Mapy542/ch32m030/ch32v307drv/layout images/Screenshot_20260525_173055.png

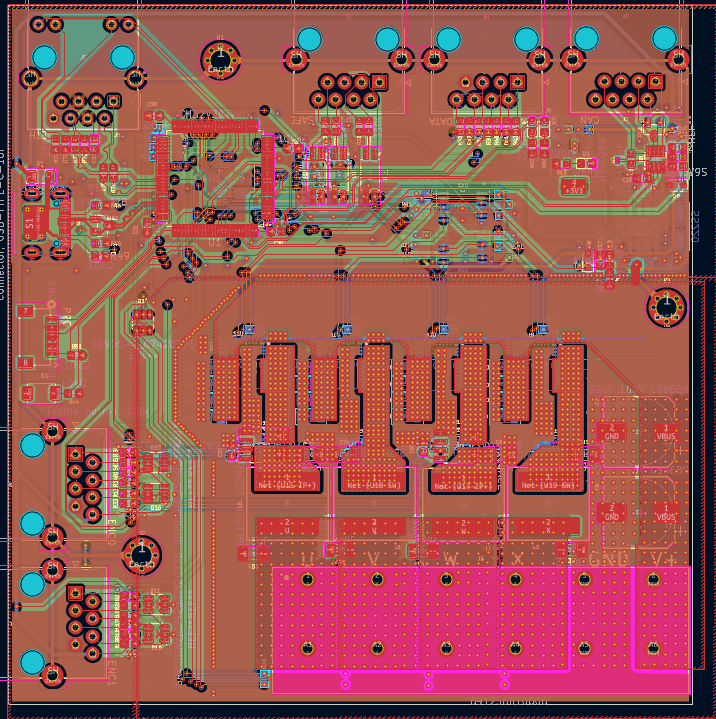
ch32v307drv/layout images/Screenshot_20260525_173055.png
