Mapy542/ch32m030/ch32v307drv/BSC019N06NSATMA1 (1)/BSC019N06NSATMA1.step

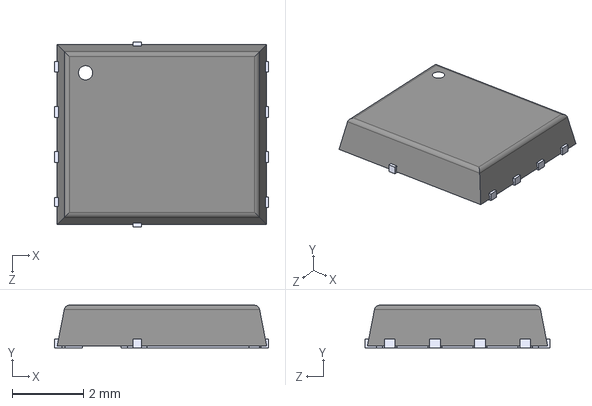
[picture p15: CAD file, 2026-04-23]
ch32v307drv/BSC019N06NSATMA1 (1)/BSC019N06NSATMA1.step
6.03 x 1.20 x 5.21 mm
