Mapy542/ch32m030/ch32v307drv/CH221K/CH221K.step

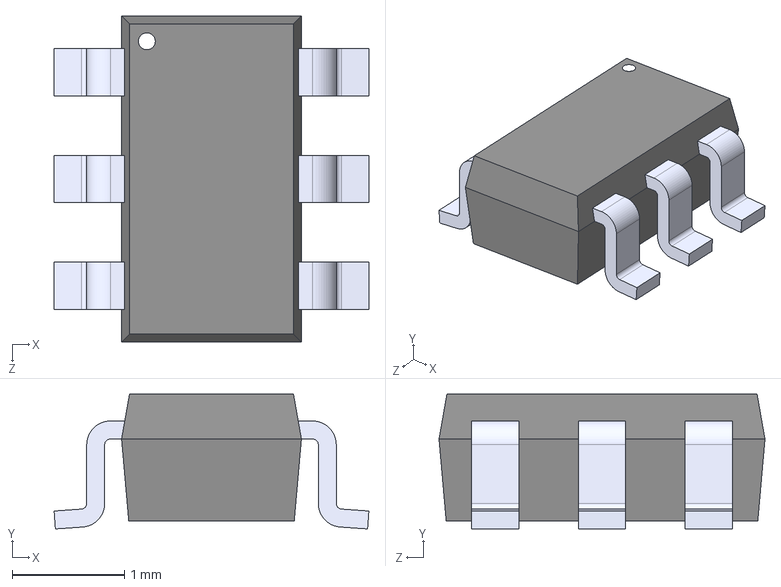
[picture p16: CAD file, 2026-04-23]
ch32v307drv/CH221K/CH221K.step
2.80 x 1.20 x 2.90 mm
