Mapy542/ch32m030/ch32v307drv/SM06B_SRSS_TB_LF__SN_/KiCADv6/SM06B-SRSS-TB.STEP

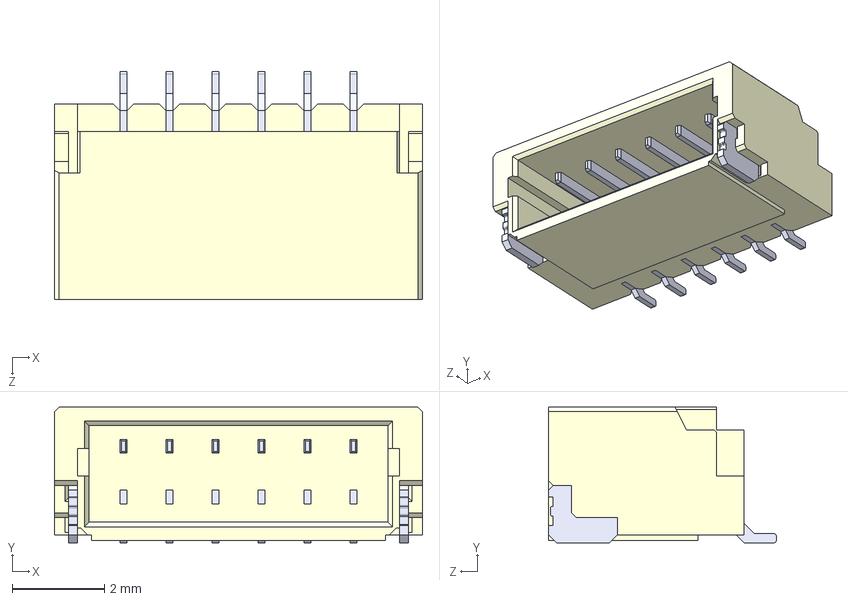
[picture p17: CAD file, 2026-04-23]
ch32v307drv/SM06B_SRSS_TB_LF__SN_/KiCADv6/SM06B-SRSS-TB.STEP
8.00 x 2.95 x 4.95 mm
