Mapy542/ch32m030/ch32v307drv/SS_641010S_A_NF (1)/SS-641010S-A-NF.STEP

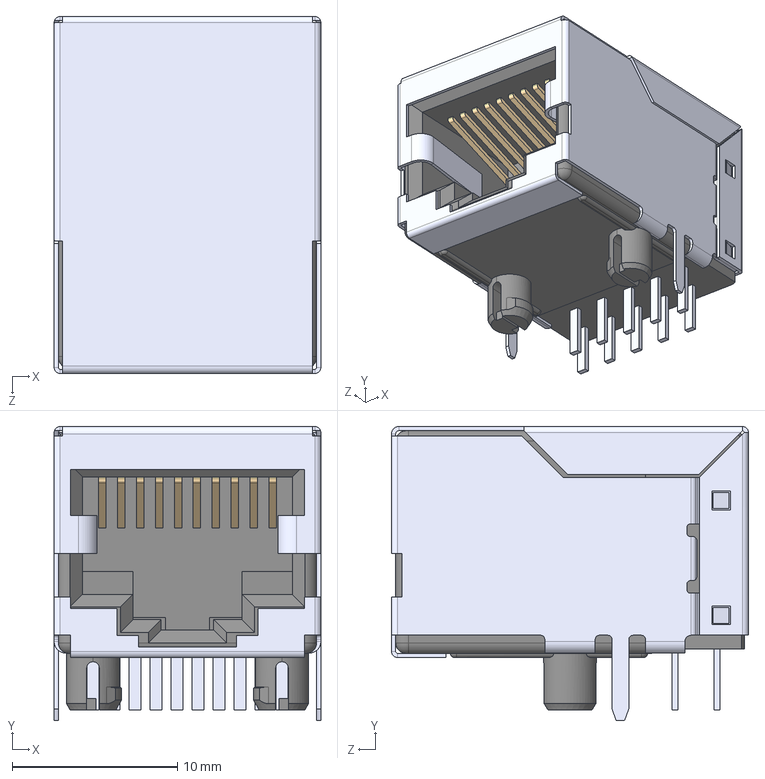
[picture p18: CAD file, 2026-06-03]
ch32v307drv/SS_641010S_A_NF (1)/SS-641010S-A-NF.STEP
16.1 x 17.8 x 21.6 mm
