Mapy542/ch32m030/ch32v307drv/SS_6466S_A_PG1/SS-6466S-A-PG1.stp

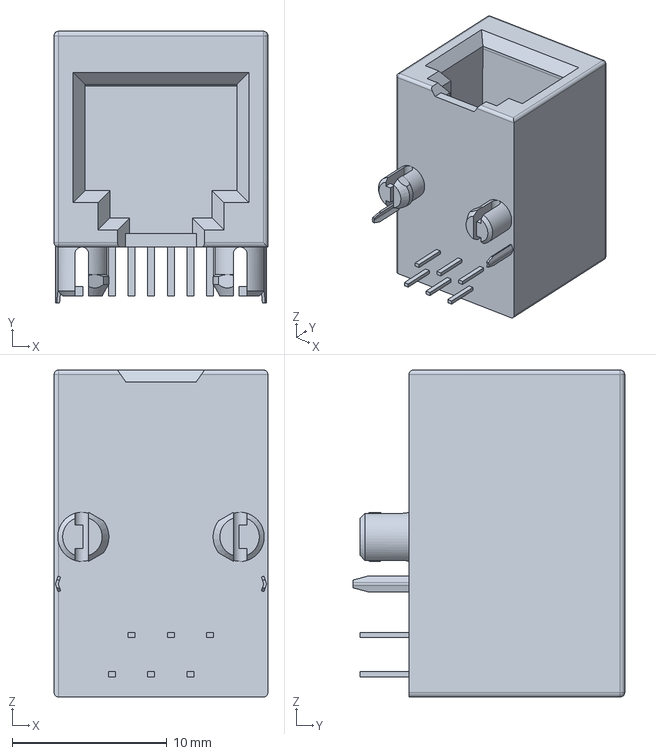
[picture p19: CAD file, 2026-06-03]
ch32v307drv/SS_6466S_A_PG1/SS-6466S-A-PG1.stp
13.8 x 17.6 x 21.2 mm
