Mapy542/ch32m030/ch32v307drv/TBL002A_350_10GY_2GY (1)/TBL002A-350-10GY-2GY.step

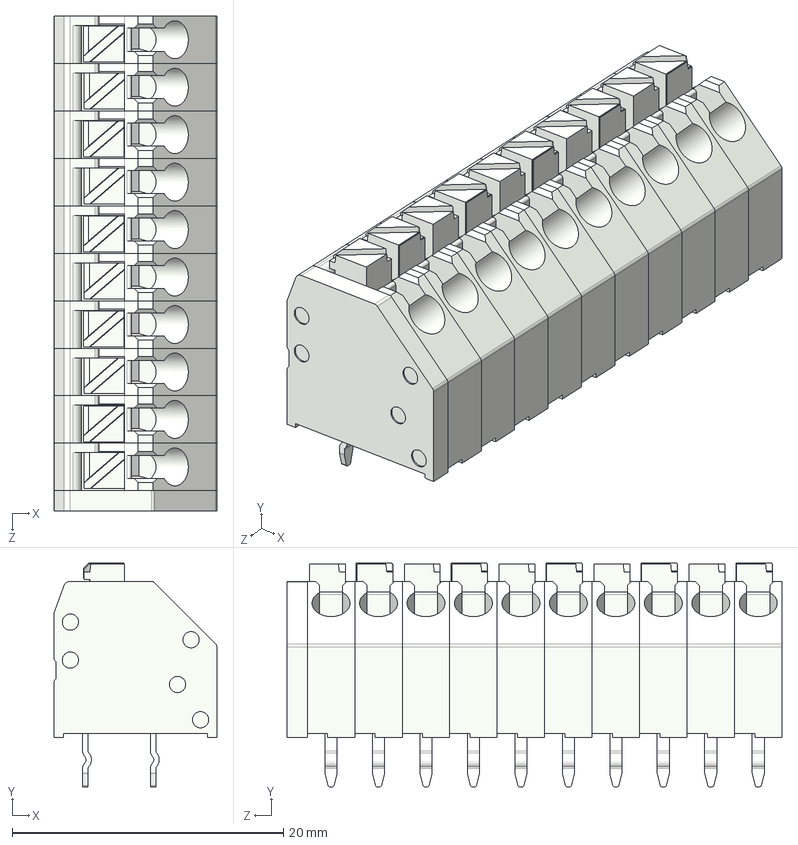
[picture p20: CAD file, 2026-04-23]
ch32v307drv/TBL002A_350_10GY_2GY (1)/TBL002A-350-10GY-2GY.step
12.0 x 16.5 x 36.5 mm
TBL002A-350 - END CAP_Gray
TBL002A-350 - BODY A_Gray x 5
TBL002A-350 - BODY B_Gray x 5
TBL002A-350 - PUSH BUTTON A_Gray x 5
TBL002A-350 - PUSH BUTTON B_Gray x 5
