Mapy542/ch32m030/ch32v307drv/691256610006 (1)/691256610006.stp

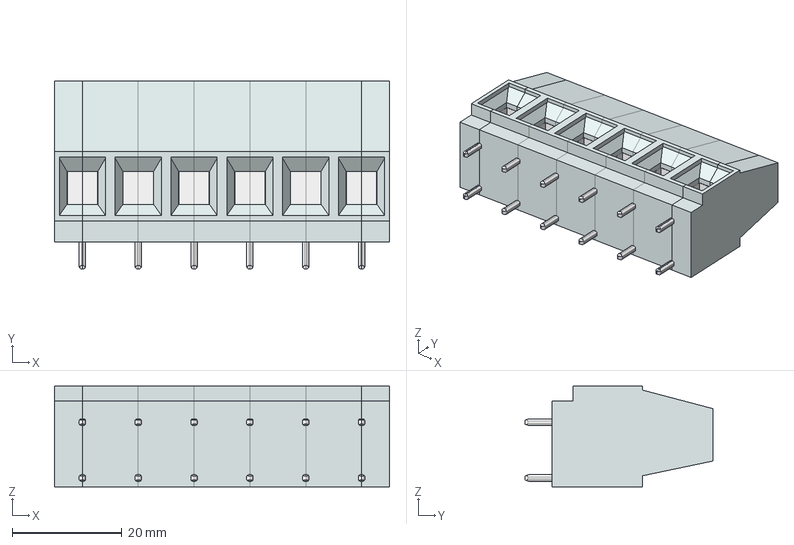
[picture p21: CAD file, 2026-04-23]
ch32v307drv/691256610006 (1)/691256610006.stp
61.0 x 34.3 x 18.3 mm
MRT26P10.16_SX
MRT26P10.16_CNT x 5
MRT26P10.16_DX
