Mapy542/ch32m030/ch32m030/ch32m030.kicad_pcb

## KiCad design ch32m030/ch32m030.kicad_pcb (2026-06-03)

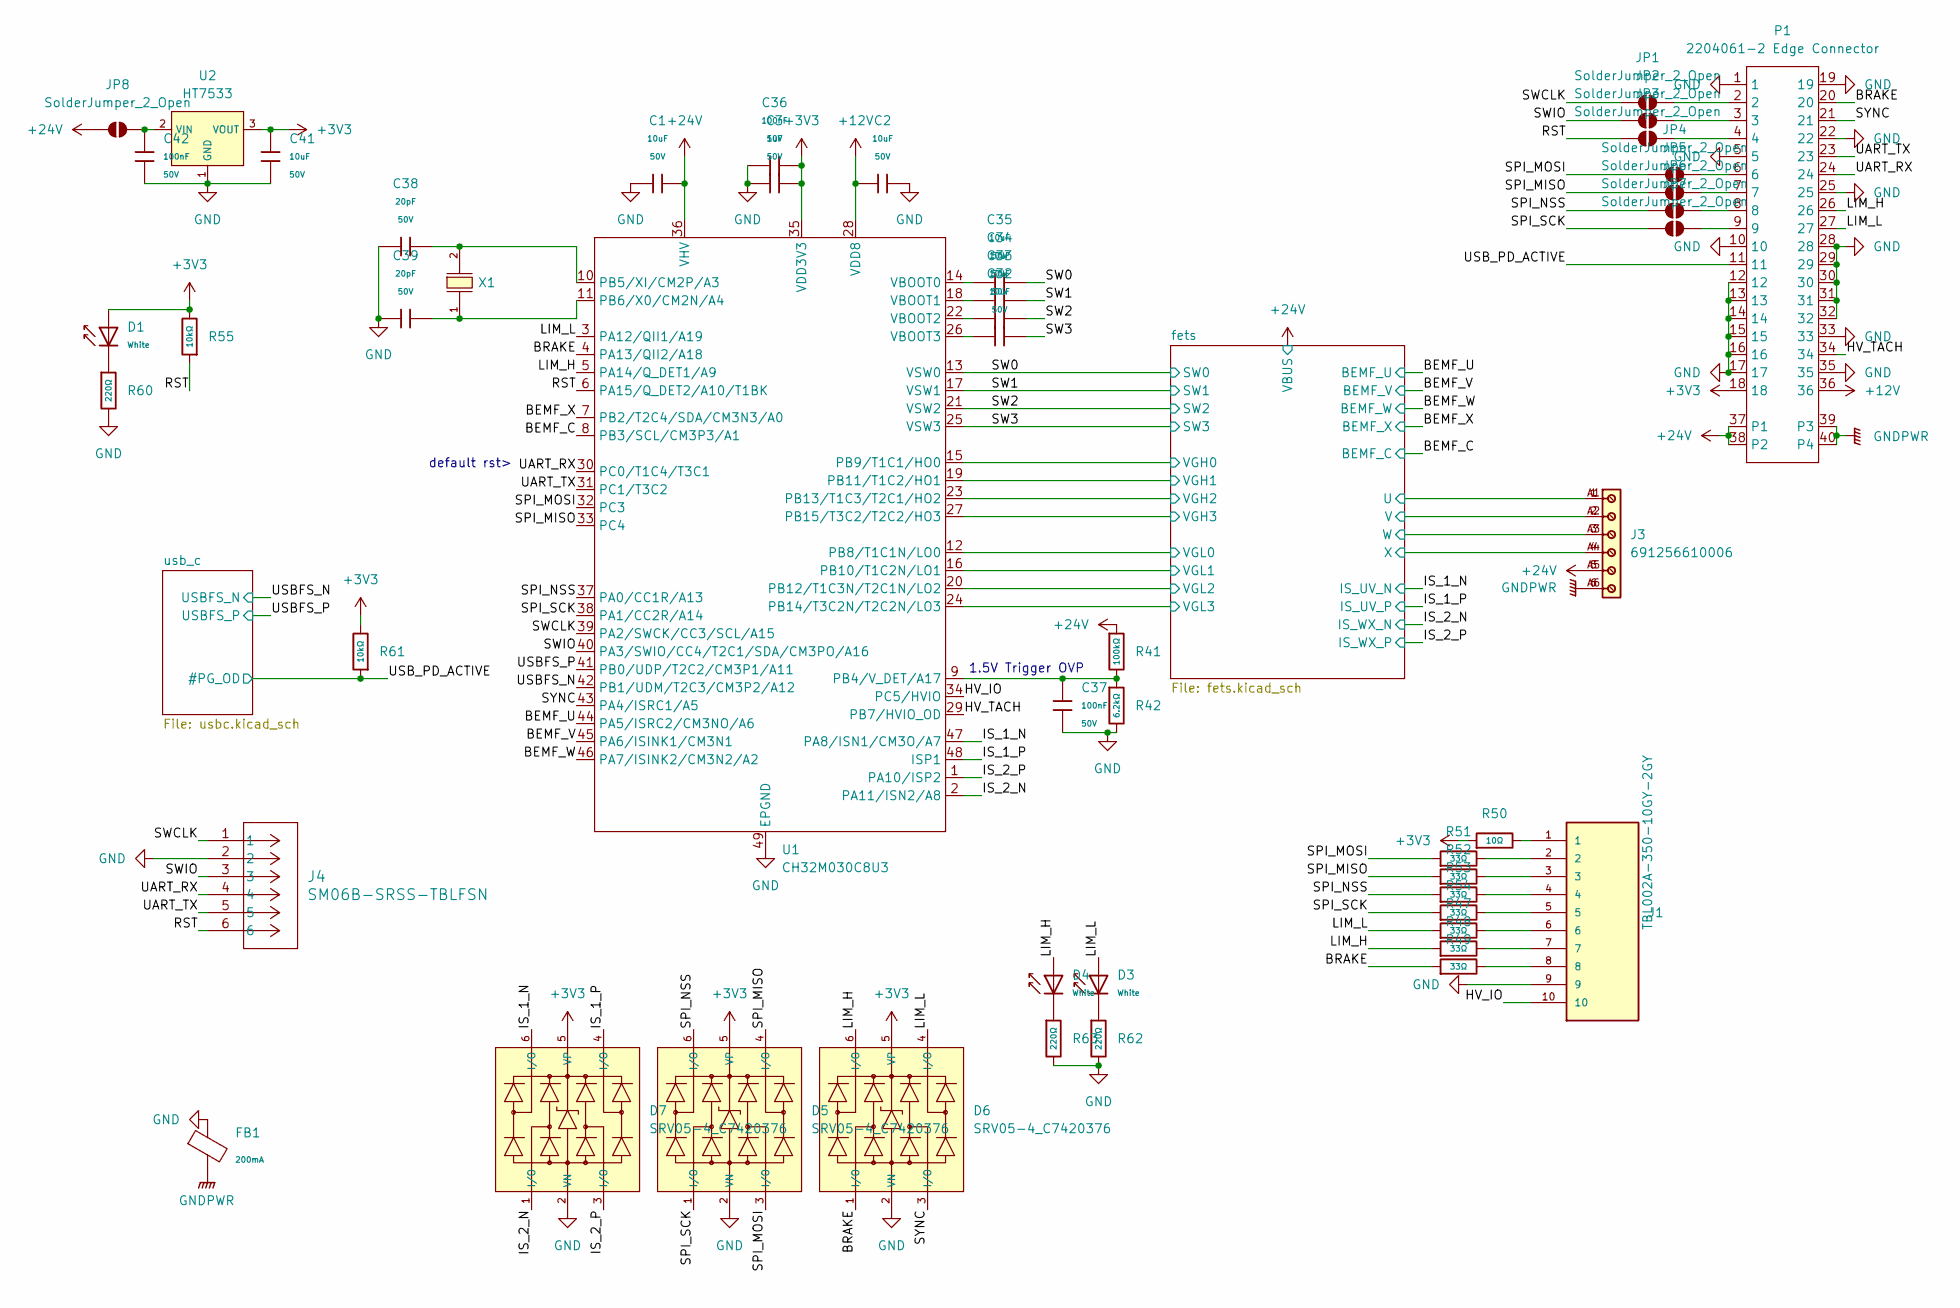
[picture p22: schematic ch32m030.kicad_sch]

Parts:
C1, C2, C32, C33, C34, C35, C41: 10uF; C_1206; Voltage Rated 50V; Tolerance ±10%; Part CL31A106KBHNNNE; LCSC C13585
C3: 1uF; C_0603; Voltage Rated 50V; Tolerance ±10%; Part CL10A105KB8NNNC; LCSC C15849
C36, C37, C42: 100nF; C_0603; Voltage Rated 50V; Tolerance ±10%; Part CC0603KRX7R9BB104; LCSC C14663
C38, C39: 20pF; C_0402; Voltage Rated 50V; Tolerance ±5%; Part 0402CG200J500NT; LCSC C1554
D1, D3, D4: White; D_0603; Part KT-0603W; LCSC C2290
D5, D6, D7: SRV05-4_C7420376; SOT-23-6_L2.9-W1.6-P0.95-LS2.8-BL-1; Breakdown Voltage (Vbr) 6V; Clamping Voltage@Ipp 12.5V; Part SRV05-4; LCSC C7420376
FB1: FB_0603; Current Rating 200mA; Tolerance ±25%; Part GZ1608D601TF; LCSC C1002
J1: TBL002A-350-10GY-2GY; CUI_TBL002A-350-10GY-2GY; PARTREV 1.0
J3: 691256610006
J4: SM06B-SRSS-TBLFSN; CONN_SM06B-SRSS-TB_JST
JP1, JP2, JP3, JP4, JP5, JP6, JP7, JP8: SolderJumper_2_Open; SolderJumper-2_P1.3mm_Open_TrianglePad1.0x1.5mm
P1: 2204061-2 Edge Connector; edge
R41: 100kΩ; R_0603; Overload Voltage (Max) 75V; Tolerance ±1%; Part 0603WAF1003T5E; LCSC C25803
R42: 6.2kΩ; R_0603; Overload Voltage (Max) 75V; Tolerance ±1%; Part 0603WAF6201T5E; LCSC C4260
R47, R48, R49, R51, R52, R53, R54: 33Ω; R_0603; Overload Voltage (Max) 75V; Tolerance ±1%; Part 0603WAF330JT5E; LCSC C23140
R50: 10Ω; R_0603; Overload Voltage (Max) 75V; Tolerance ±1%; Part 0603WAF100JT5E; LCSC C22859
R55, R61: 10kΩ; R_0603; Overload Voltage (Max) 75V; Tolerance ±1%; Part 0603WAF1002T5E; LCSC C25804
R60, R62, R63: 220Ω; R_0603; Overload Voltage (Max) 75V; Tolerance ±1%; Part 0603WAF2200T5E; LCSC C22962
U1: CH32M030C8U3; QFN-48-1EP_7x7mm_P0.5mm_EP3.5x3.5mm
U2: HT7533; SOT-89-3_L4.5-W2.5-P1.50-LS4.2-BR; Output Voltage 3.3V; Dropout Voltage 55mV@(1mA); Part HT7533-1; LCSC C14289
X1: X50328MSB2GI; CRYSTAL-SMD_L5.0-W3.2; Frequency Tolerance ±10ppm; Part X50328MSB2GI; LCSC C115962

Connections:
+3V3: C3.2, C36.2, C41.2, D1.2, D5.5 (VP), D6.5 (VP), D7.5 (VP), P1.18, R50.1, R55.2, R61.2, U1.35 (VDD3V3), U2.3 (VOUT); also elsewhere on the board
+12V: C2.1, P1.36, U1.28 (VDD8)
+24V: C1.1, J3.5, J3.A5, JP8.1 (A), P1.37 (P1), P1.38 (P2), R41.1, U1.36 (VHV); also elsewhere on the board
/BEMF_C: U1.8 (PB3/SCL/CM3P3/A1); also elsewhere on the board
/BEMF_U: U1.44 (PA5/ISRC2/CM3NO/A6); also elsewhere on the board
/BEMF_V: U1.45 (PA6/ISINK1/CM3N1); also elsewhere on the board
/BEMF_W: U1.46 (PA7/ISINK2/CM3N2/A2); also elsewhere on the board
/BEMF_X: U1.7 (PB2/T2C4/SDA/CM3N3/A0); also elsewhere on the board
/BRAKE: D6.1 (I/O), P1.20, R49.1, U1.4 (PA13/QII2/A18)
/HV_IO: J1.10, U1.34 (PC5/HVIO)
/HV_TACH: P1.34, U1.29 (PB7/HVIO_OD)
/IS_1_N: D7.6 (I/O), U1.47 (PA8/ISN1/CM3O/A7); also elsewhere on the board
/IS_1_P: D7.4 (I/O), U1.48 (ISP1); also elsewhere on the board
/IS_2_N: D7.1 (I/O), U1.2 (PA11/ISN2/A8); also elsewhere on the board
/IS_2_P: D7.3 (I/O), U1.1 (PA10/ISP2); also elsewhere on the board
/LIM_H: D4.2, D6.6 (I/O), P1.26, R48.1, U1.5 (PA14/Q_DET1/A9)
/LIM_L: D3.2, D6.4 (I/O), P1.27, R47.1, U1.3 (PA12/QII1/A19)
/RST: J4.6, JP3.1 (A), R55.1, U1.6 (PA15/Q_DET2/A10/T1BK)
/SPI_MISO: D5.4 (I/O), JP5.1 (A), R52.1, U1.33 (PC4)
/SPI_MOSI: D5.3 (I/O), JP4.1 (A), R51.1, U1.32 (PC3)
/SPI_NSS: D5.6 (I/O), JP6.1 (A), R53.1, U1.37 (PA0/CC1R/A13)
/SPI_SCK: D5.1 (I/O), JP7.1 (A), R54.1, U1.38 (PA1/CC2R/A14)
/SW0: C35.2, J3.1, J3.A1, U1.13 (VSW0); also elsewhere on the board
/SW1: C34.2, J3.2, J3.A2, U1.17 (VSW1); also elsewhere on the board
/SW2: C33.2, J3.3, J3.A3, U1.21 (VSW2); also elsewhere on the board
/SW3: C32.2, J3.4, J3.A4, U1.25 (VSW3); also elsewhere on the board
/SWCLK: J4.1, JP1.1 (A), U1.39 (PA2/SWCK/CC3/SCL/A15)
/SWIO: J4.3, JP2.1 (A), U1.40 (PA3/SWIO/CC4/T2C1/SDA/CM3PO/A16)
/SYNC: D6.3 (I/O), P1.21, U1.43 (PA4/ISRC1/A5)
/UART_RX: J4.4, P1.24, U1.30 (PC0/T1C4/T3C1)
/UART_TX: J4.5, P1.23, U1.31 (PC1/T3C2)
/USBFS_N: U1.42 (PB1/UDM/T2C3/CM3P2/A12); also elsewhere on the board
/USBFS_P: U1.41 (PB0/UDP/T2C2/CM3P1/A11); also elsewhere on the board
/USB_PD_ACTIVE: P1.11, R61.1; also elsewhere on the board
/fets/VGH0: U1.15 (PB9/T1C1/HO0); also elsewhere on the board
/fets/VGH1: U1.19 (PB11/T1C2/HO1); also elsewhere on the board
/fets/VGH2: U1.23 (PB13/T1C3/T2C1/HO2); also elsewhere on the board
/fets/VGH3: U1.27 (PB15/T3C2/T2C2/HO3); also elsewhere on the board
/fets/VGL0: U1.12 (PB8/T1C1N/LO0); also elsewhere on the board
/fets/VGL1: U1.16 (PB10/T1C2N/LO1); also elsewhere on the board
/fets/VGL2: U1.20 (PB12/T1C3N/T2C1N/LO2); also elsewhere on the board
/fets/VGL3: U1.24 (PB14/T3C2N/T2C2N/LO3); also elsewhere on the board
GND: C1.2, C2.2, C3.1, C36.1, C37.1, C38.1, C39.1, C41.1, C42.1, D5.2 (VN), D6.2 (VN), D7.2 (VN), FB1.1, J1.9, J4.2, P1.1, P1.5, P1.10, P1.12, P1.13, P1.14, P1.15, P1.16, P1.17, P1.19, P1.22, P1.25, P1.28, P1.29, P1.30, P1.31, P1.32, P1.33, P1.35, R42.2, R60.2, R62.2, R63.2, U1.49 (EPGND), U2.1 (GND); also elsewhere on the board
GNDPWR: FB1.2, J3.6, J3.A6, P1.39 (P3), P1.40 (P4); also elsewhere on the board
unnamed: D1.1, R60.1
unnamed: D3.1, R62.1
unnamed: D4.1, R63.1
unnamed: J1.1, R50.2
unnamed: J1.2, R51.2
unnamed: J1.3, R52.2
unnamed: J1.4, R53.2
unnamed: J1.5, R54.2
unnamed: J1.6, R47.2
unnamed: J1.7, R48.2
unnamed: J1.8, R49.2
unnamed: JP1.2 (B), P1.2
unnamed: JP2.2 (B), P1.3
unnamed: JP3.2 (B), P1.4
unnamed: JP4.2 (B), P1.6
unnamed: JP5.2 (B), P1.7
unnamed: JP6.2 (B), P1.8
unnamed: JP7.2 (B), P1.9
unnamed: C42.2, JP8.2 (B), U2.2 (VIN)
unnamed: C37.2, R41.2, R42.1, U1.9 (PB4/V_DET/A17)
unnamed: C38.2, U1.10 (PB5/XI/CM2P/A3), X1.2
unnamed: C39.2, U1.11 (PB6/X0/CM2N/A4), X1.1
unnamed: C35.1, U1.14 (VBOOT0)
unnamed: C34.1, U1.18 (VBOOT1)
unnamed: C33.1, U1.22 (VBOOT2)
unnamed: C32.1, U1.26 (VBOOT3)

Notes on the sheet:
1.5V Trigger OVP
default rst>

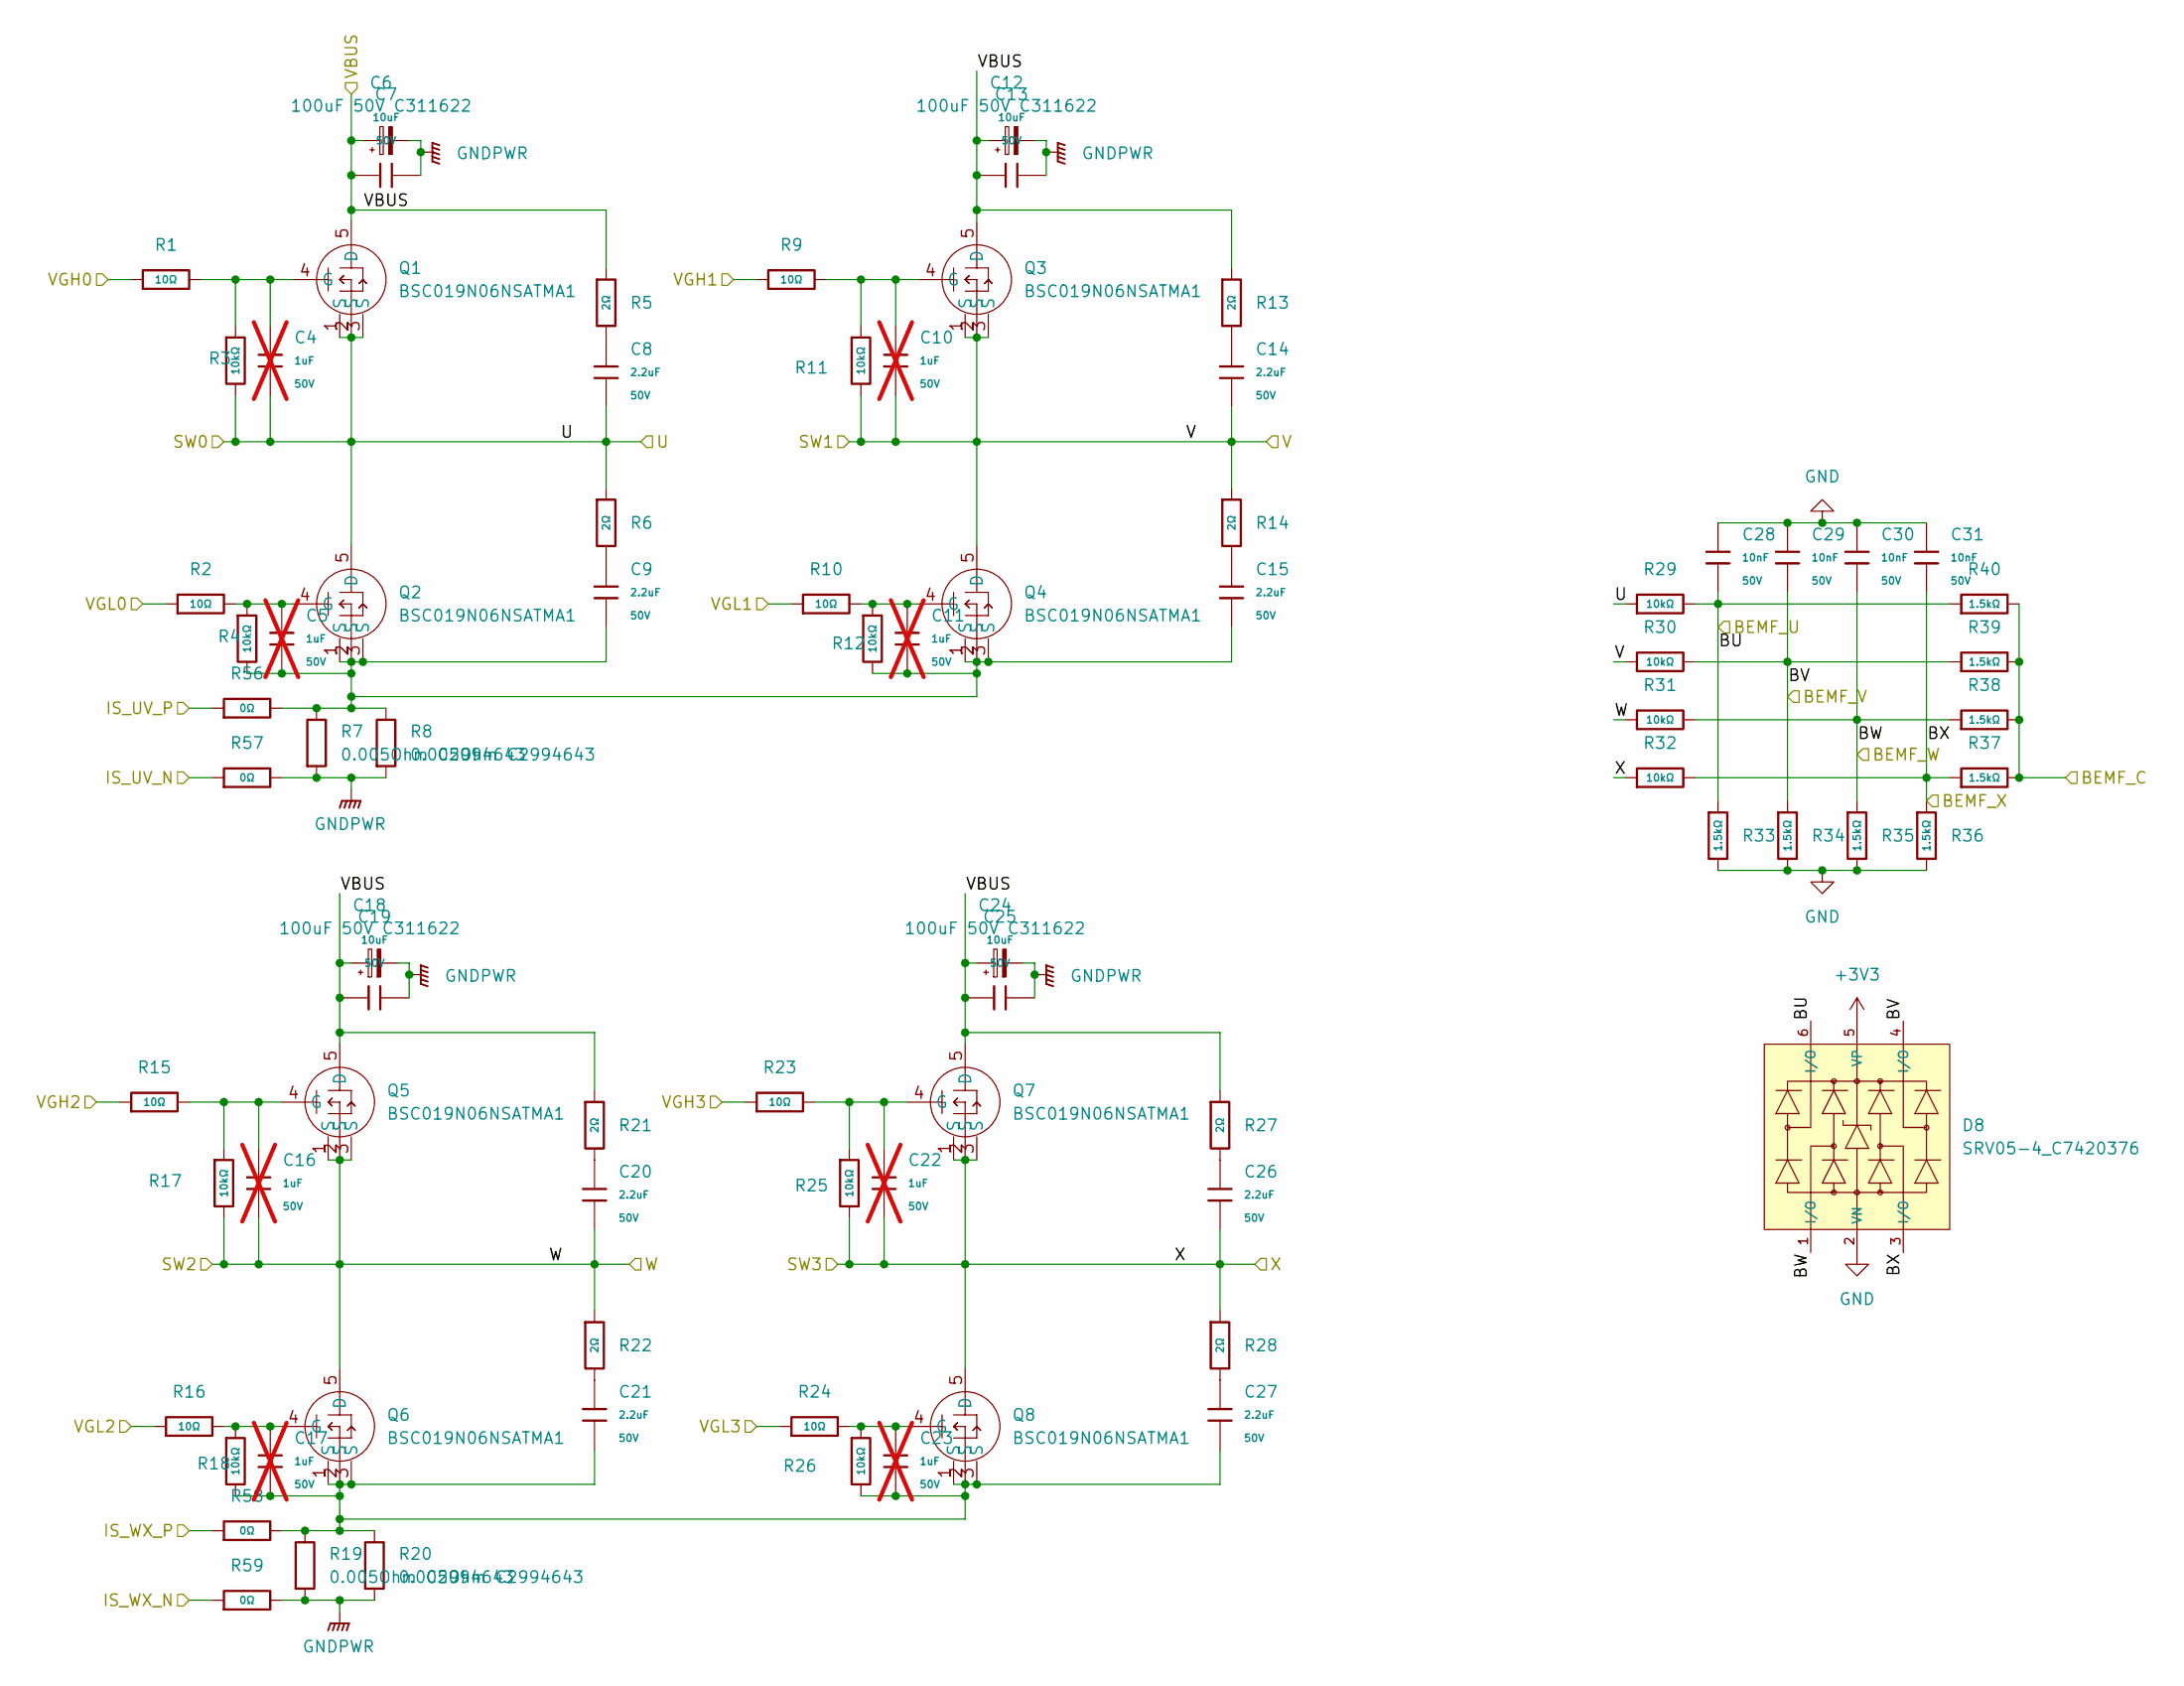
[picture p23: schematic fets.kicad_sch]

Parts:
C4, C5, C10, C11, C16, C17, C22, C23: 1uF; C_0603; Voltage Rated 50V; Tolerance ±10%; Part CL10A105KB8NNNC; LCSC C15849; not fitted
C6, C12, C18, C24: 100uF 50V C311622; CP_Elec_6.3x7.7
C7, C13, C19, C25: 10uF; C_1206; Voltage Rated 50V; Tolerance ±10%; Part CL31A106KBHNNNE; LCSC C13585
C8, C9, C14, C15, C20, C21, C26, C27: 2.2uF; C_1206; Voltage Rated 50V; Tolerance ±10%; Part CL31B225KBHNNNE; LCSC C50254
C28, C29, C30, C31: 10nF; C_0603; Voltage Rated 50V; Tolerance ±10%; Part 0603B103K500NT; LCSC C57112
D8: SRV05-4_C7420376; SOT-23-6_L2.9-W1.6-P0.95-LS2.8-BL-1; Breakdown Voltage (Vbr) 6V; Clamping Voltage@Ipp 12.5V; Part SRV05-4; LCSC C7420376
Q1, Q2, Q3, Q4, Q5, Q6, Q7, Q8: BSC019N06NSATMA1; Infineon_PG-TDSON-8_6.15x5.15mm
R1, R2, R9, R10, R15, R16, R23, R24: 10Ω; R_0603; Overload Voltage (Max) 75V; Tolerance ±1%; Part 0603WAF100JT5E; LCSC C22859
R3, R4, R11, R12, R17, R18, R25, R26, R29, R30, R31, R32: 10kΩ; R_0603; Overload Voltage (Max) 75V; Tolerance ±1%; Part 0603WAF1002T5E; LCSC C25804
R5, R6, R13, R14, R21, R22, R27, R28: 2Ω; R_0603; Overload Voltage (Max) 75V; Tolerance ±1%; Part 0603WAF200KT5E; LCSC C22977
R7, R8, R19, R20: 0.005Ohm C2994643; R_2512_6332Metric
R33, R34, R35, R36, R37, R38, R39, R40: 1.5kΩ; R_0603; Overload Voltage (Max) 75V; Tolerance ±1%; Part 0603WAF1501T5E; LCSC C22843
R56, R57, R58, R59: 0Ω; R_0603; Overload Voltage (Max) 75V; Tolerance ±1%; Part 0603WAF0000T5E; LCSC C21189

Connections:
+3V3: D8.5 (VP); also elsewhere on the board
+24V: C6.1, C7.1, C12.1, C13.1, C18.1, C19.1, C24.1, C25.1, Q1.5 (D), Q3.5 (D), Q5.5 (D), Q7.5 (D), R5.1, R13.1, R21.1, R27.1; also elsewhere on the board
/BEMF_C: R37.2, R38.2, R39.2, R40.2; also elsewhere on the board
/BEMF_U: C28.2, D8.6 (I/O), R29.2, R33.1, R40.1; also elsewhere on the board
/BEMF_V: C29.2, D8.4 (I/O), R30.2, R34.1, R39.1; also elsewhere on the board
/BEMF_W: C30.2, D8.1 (I/O), R31.2, R35.1, R38.1; also elsewhere on the board
/BEMF_X: C31.2, D8.3 (I/O), R32.2, R36.1, R37.1; also elsewhere on the board
/IS_1_N: R57.1; also elsewhere on the board
/IS_1_P: R56.1; also elsewhere on the board
/IS_2_N: R59.1; also elsewhere on the board
/IS_2_P: R58.1; also elsewhere on the board
/SW0: C4.2, C8.2, Q1.1 (S), Q1.2 (S), Q1.3 (S), Q2.5 (D), R3.2, R6.1, R29.1; also elsewhere on the board
/SW1: C10.2, C14.2, Q3.1 (S), Q3.2 (S), Q3.3 (S), Q4.5 (D), R11.2, R14.1, R30.1; also elsewhere on the board
/SW2: C16.2, C20.2, Q5.1 (S), Q5.2 (S), Q5.3 (S), Q6.5 (D), R17.2, R22.1, R31.1; also elsewhere on the board
/SW3: C22.2, C26.2, Q7.1 (S), Q7.2 (S), Q7.3 (S), Q8.5 (D), R25.2, R28.1, R32.1; also elsewhere on the board
/fets/VGH0: R1.1; also elsewhere on the board
/fets/VGH1: R9.1; also elsewhere on the board
/fets/VGH2: R15.1; also elsewhere on the board
/fets/VGH3: R23.1; also elsewhere on the board
/fets/VGL0: R2.1; also elsewhere on the board
/fets/VGL1: R10.1; also elsewhere on the board
/fets/VGL2: R16.1; also elsewhere on the board
/fets/VGL3: R24.1; also elsewhere on the board
GND: C28.1, C29.1, C30.1, C31.1, D8.2 (VN), R33.2, R34.2, R35.2, R36.2; also elsewhere on the board
GNDPWR: C6.2, C7.2, C12.2, C13.2, C18.2, C19.2, C24.2, C25.2, R7.2, R8.2, R19.2, R20.2, R57.2, R59.2; also elsewhere on the board
unnamed: C8.1, R5.2
unnamed: C9.1, R6.2
unnamed: C5.2, C9.2, C11.2, C15.2, Q2.1 (S), Q2.2 (S), Q2.3 (S), Q4.1 (S), Q4.2 (S), Q4.3 (S), R4.2, R7.1, R8.1, R12.2, R56.2
unnamed: C14.1, R13.2
unnamed: C15.1, R14.2
unnamed: C17.2, C21.2, C23.2, C27.2, Q6.1 (S), Q6.2 (S), Q6.3 (S), Q8.1 (S), Q8.2 (S), Q8.3 (S), R18.2, R19.1, R20.1, R26.2, R58.2
unnamed: C20.1, R21.2
unnamed: C21.1, R22.2
unnamed: C26.1, R27.2
unnamed: C27.1, R28.2
unnamed: C4.1, Q1.4 (G), R1.2, R3.1
unnamed: C5.1, Q2.4 (G), R2.2, R4.1
unnamed: C10.1, Q3.4 (G), R9.2, R11.1
unnamed: C11.1, Q4.4 (G), R10.2, R12.1
unnamed: C16.1, Q5.4 (G), R15.2, R17.1
unnamed: C17.1, Q6.4 (G), R16.2, R18.1
unnamed: C22.1, Q7.4 (G), R23.2, R25.1
unnamed: C23.1, Q8.4 (G), R24.2, R26.1

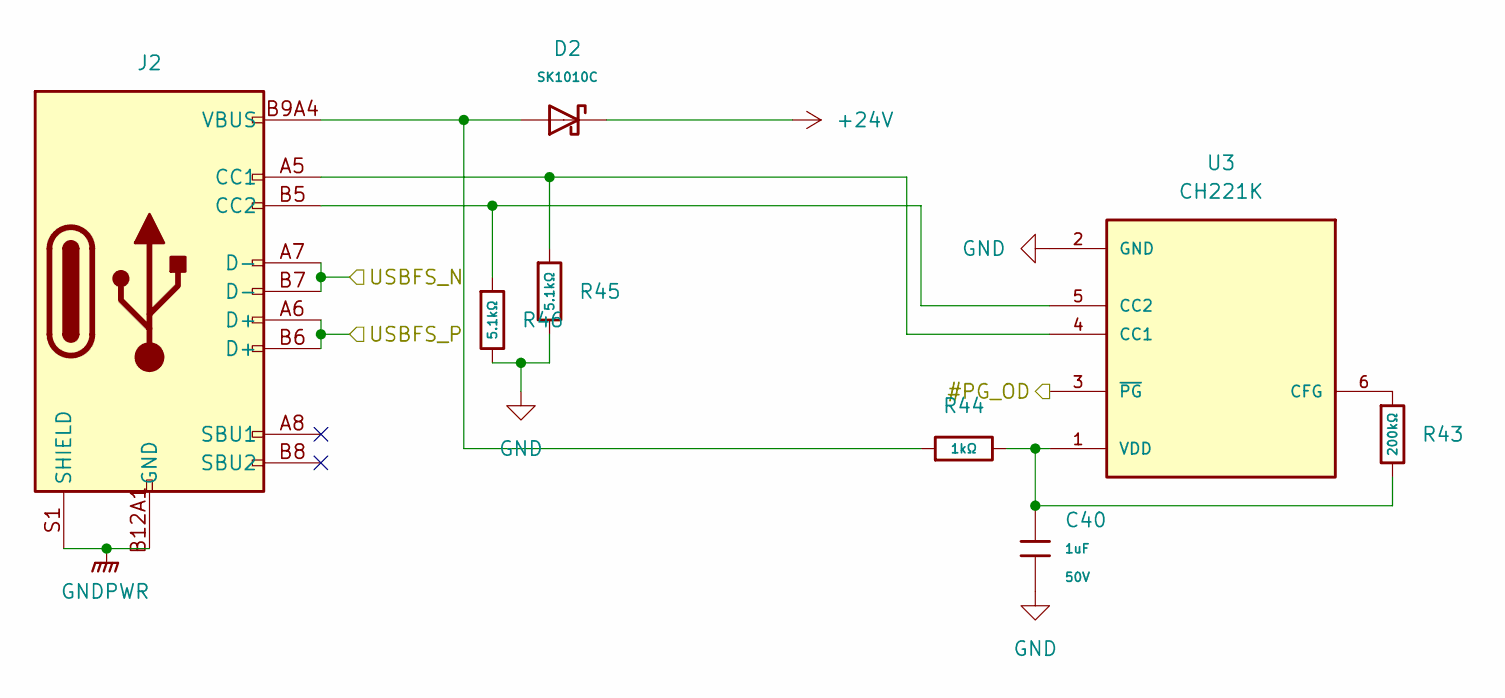
[picture p24: schematic usbc.kicad_sch]

Parts:
C40: 1uF; C_0603; Voltage Rated 50V; Tolerance ±10%; Part CL10A105KB8NNNC; LCSC C15849
D2: SK1010C; D_SMC; Forward Voltage (Vf@If) 850mV@10A; Reverse Voltage (Vr) 100V; Part SK1010C; LCSC C18199193
J2: Connector, USB-TYPE-C-16P; TYPE-C-SMD_HX-TYPE-C-16PIN; LCSC C2927039
R43: 200kΩ; R_0603; Overload Voltage (Max) 75V; Tolerance ±1%; Part 0603WAF2003T5E; LCSC C25811
R44: 1kΩ; R_0603; Overload Voltage (Max) 75V; Tolerance ±1%; Part 0603WAF1001T5E; LCSC C21190
R45, R46: 5.1kΩ; R_0603; Overload Voltage (Max) 75V; Tolerance ±1%; Part 0603WAF5101T5E; LCSC C23186
U3: CH221K; SOT95P280X120-6N; PARTREV 2.1

Connections:
+24V: D2.1; also elsewhere on the board
/USBFS_N: J2.A7 (D-), J2.B7 (D-); also elsewhere on the board
/USBFS_P: J2.A6 (D+), J2.B6 (D+); also elsewhere on the board
/USB_PD_ACTIVE: U3.3 (~PG); also elsewhere on the board
GND: C40.1, R45.2, R46.2, U3.2 (GND); also elsewhere on the board
GNDPWR: J2.A12B1 (GND), J2.B12A1 (GND), J2.S1 (SHIELD); also elsewhere on the board
unnamed: D2.2, J2.A9B4 (VBUS), J2.B9A4 (VBUS), R44.1
unnamed: J2.A5 (CC1), R45.1, U3.4 (CC1)
unnamed: J2.B5 (CC2), R46.1, U3.5 (CC2)
unnamed: R43.1, U3.6 (CFG)
unnamed: C40.2, R43.2, R44.2, U3.1 (VDD)

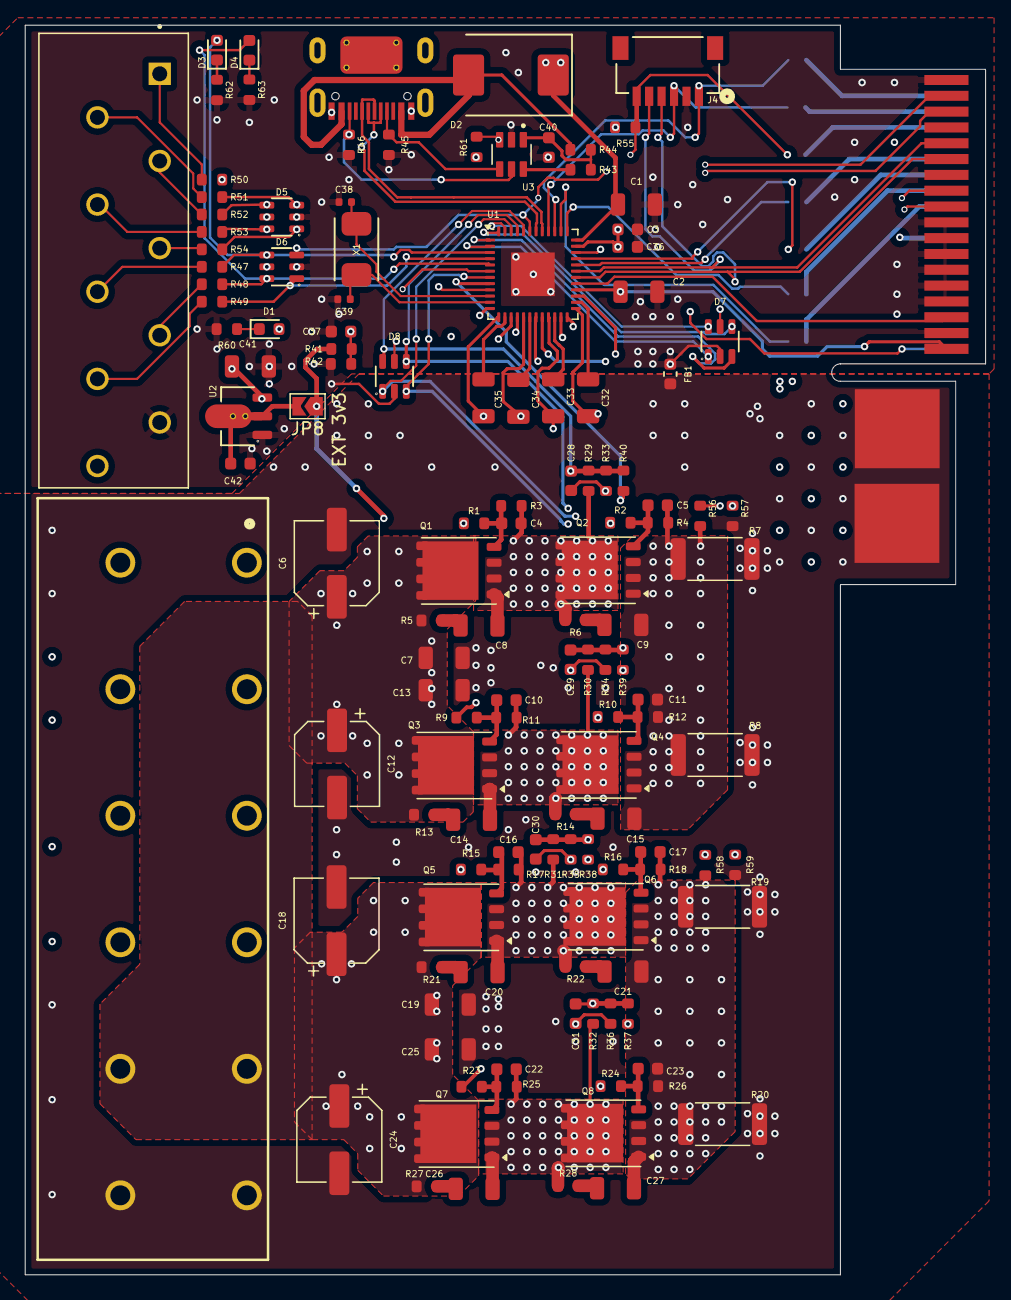
[picture p25: board ch32m030.kicad_pcb from above]

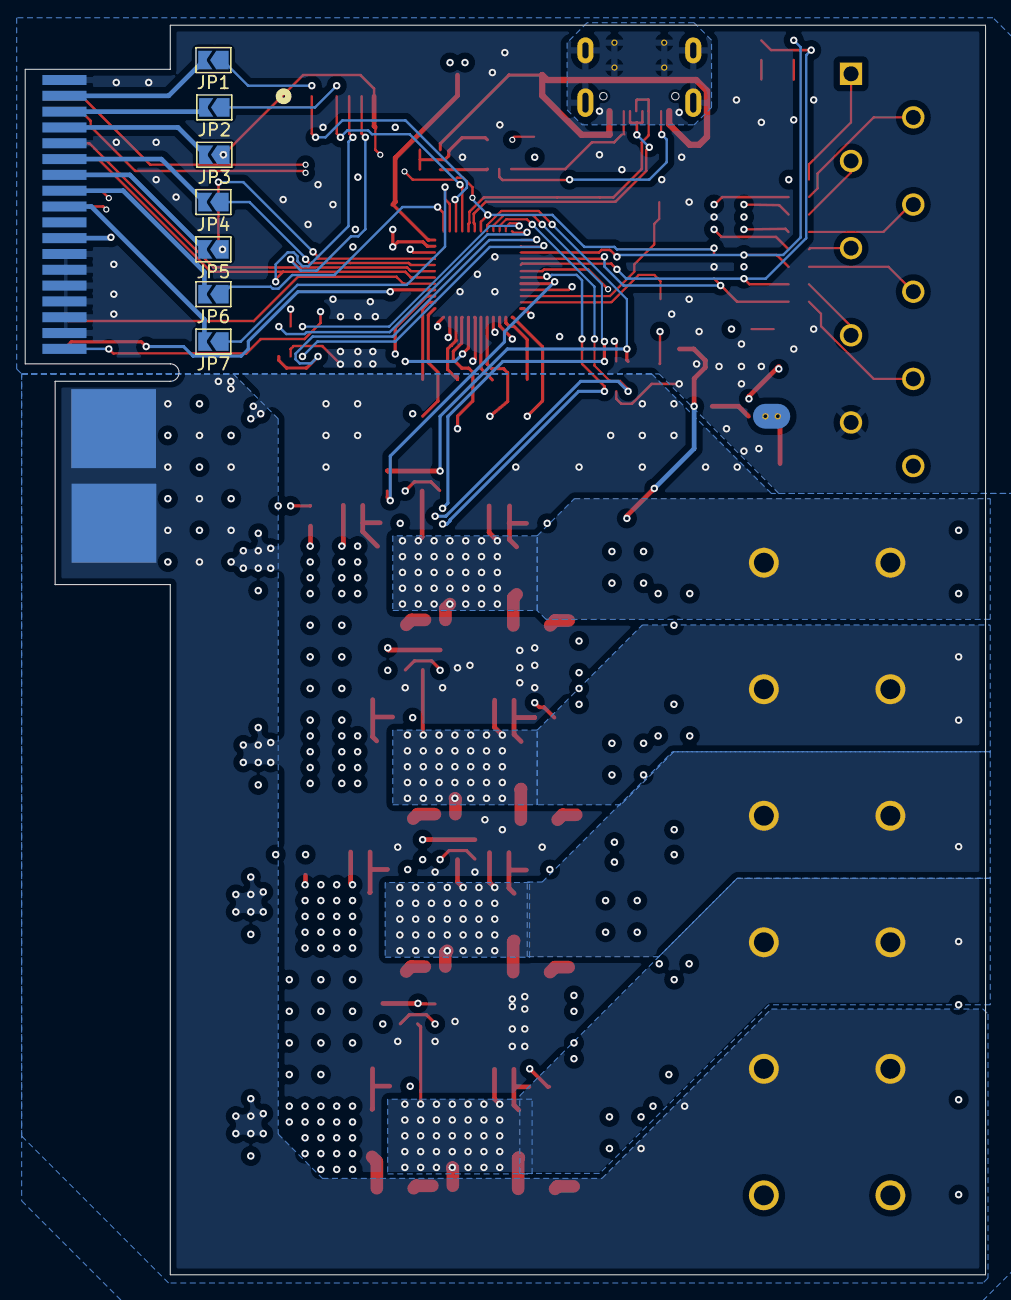
[picture p26: board ch32m030.kicad_pcb from below]

Board: 4 copper layers, 77.1 x 100.3 mm, 139 parts (7 on the bottom side), 93 nets.
