Mapy542/ch32m030/(commit log)

2026-04-23 ch32m030 card board
    [691256610006.stp, BOM-ch32m030.csv, BSC019N06NSATMA1.step, CH221K.step, SM06B-SRSS-TB.STEP, TBL002A-350-10GY-2GY.step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]
2026-04-24 update board
    [ch32m030.kicad_pcb, ch32m030.kicad_sch]
2026-05-05 add ch32v307drv
    [691256610006.stp, BOM-ch32m030.csv, BSC019N06NSATMA1.step, CH221K.step, SM06B-SRSS-TB.STEP, TBL002A-350-10GY-2GY.step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]
2026-05-08 more design
    [SS-641010S-A-NF.STEP, SS-6466S-A-PG1.stp, buck.kicad_sch, can.kicad_sch, ch32v307drv.kicad_pcb, ch32v307drv.kicad_sch, encoder1.kicad_sch, ganfets.kicad_sch]
2026-06-03 update to share
    [691256610006.stp, BOM-ch32v307drv.csv, BSC019N06NSATMA1.step, CH221K.step, SM06B-SRSS-TB.STEP, SS-641010S-A-NF.STEP, SS-6466S-A-PG1.stp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]
2026-06-04 add rs-422 termination resistors
    [encoder1.kicad_sch]
