Mapy542/ch32m030/(notices)

Notices in the files:
ch32v307drv/SS_6466S_A_PG1/SS-6466S-A-PG1.stp:
FILE_NAME( 'C:/Users/KMIROS~1/AppData/Local/Temp/psolqas_2196_39.stp', '2022-01-10T15:07:50', ( 'License CC BY-ND 4.0' ), ( 'CADENAS' ), ' ', 'PARTsolutions', ' ' );
